ddenchevDev/Electronics-Projects-Public/System_requirements.docx

Stage 1 – Broad description

“Mixed-Signal , Mono, DSP Guitar effects pedal”

How is it going to be used?: Simple effects will be implemented – filters, distortion/overdrive, compression, time-based effects, modulation effects

Stage 2 – Deep Dive

Power? – 9V power input ( female barrel connector – 5.5/2.1mm) from standard guitar pedal PSU

Mono? – Mono single channel converters (ADC + DAC/CODEC)

Guitar Effects Pedal:

- Enclosure - Must fit in a standard Hammond 1590B enclosure
- Sample Rate – 44.1 – 48kHz sattisfies the Nyquist limit for a guitar pedal, where the maximum input frequency to be sampled is 20kHz
- Bit Depth – 24 bits
- Power - 9V power input ( female barrel connector – 5.5/2.1mm) from standard guitar pedal PSU
- USB Data Streaming
- Analog IO – 6.3mm female phone jacks
- Controls – 3 potentiometers -> 3 internal ADC channels for low frequency polling. 2 switches -> 2 digital inputs
- User interface – 1 led for tap tempo/modulation speed indication -> digital output with PWM channel

Stage 3 – Simplified Block Diagram

Power Supply

Processor

Data Converters

Input Connector

Output Connector

USB Connector

User Interface

Stage 4 – Adding details

4.1.USB

- USB 2.0 Full-Speed – only single channel audio streaming will be used. For an audio bit depth of 24 bits (transferred using a 32-bit frame) and a sampling frequency of 48kHz (worst case), the resulting data bandwidth will be:

24 bits * 48k samples/s = 1.536Mb/s

The USB 2.0 Full-Speed standard specifies a bandwidth of 12Mb/s -> can comfortably be used for single channel data transmission

- USB type C connector – widely used and supported in today’s designs

4.2.Processor

Initial Considerations:

- Peripherals – USB 2.0 Full Speed, 2 x I2S channels, 3 internal ADC channels for control potentiometers, I2C and SPI (for configuration of converters), Serial-wire debug
- RAM – enough to support RAM intensive DSP effects. Time based Delay/Reverb effects consume large ammounts of RAM e.g. for a 1s audio delay:

48k samples/s * 32 bit frame = 192 000 B = 187.5 KB

USB stack + middleware = 20-40 KB

230KB as a rough bare minimum!

- Design-friendly package – LQFP – simpler PCB design and lower production costs 🙂
- Availability and support – should have a large stock in the major parts distributors and should be active
- Processing power – Arm Cortex M4 Processors are more than sufficient for simple DSP tasks

Final Choice – STM32F469

4.3.Power Supplies

Initial Considerations:

- Digital and Analog supplies will be split

- Digital supply – switching regulator(s) will be used since the digital circuitry is far more tolerant to noise.

- Analog supply – a simple LDO regulator can be used as analog circuitry typically draws currents in the 10s of mA maximum, so regulator efficiency shouldn’t be of concern. Analog supplies also require a clean, low-noise supply, so switching converters are not an option

- Power Input – Standard 9V guitar pedal PSU. Usually these PSUs are stabilized ,and even slight variations in the output voltage shouldn’t cause issues with regulator drop-out voltages as there is plenty of margin.

4.4.Converters

Initial Considerations:

- Bit depth – 24 bits will provide good SNR ratio and is also a widely used standard for audio processing application
- Sampling rate – higher sampling rates (with a higher Nyquist limit!) result in less aliasing, however the negative side effect is increased data bandwidth to be processed and transferred. 44.1-48kHz is the optimum middle ground for guitar pedal architectures
- Interfaces:
- I2S for data streaming. Many MCUs have an I2S module implemented (including the chosen F469 MCU).
- SPI or I2C for configuration – either will work sufficiently
- Design-Friendly Package – TSSOP, SOIC and LQFP packages are less costly to assemble and easier to debug

Final selection: Cirrus Logic CS4270-CZZR

Advantages:

- Low cost – 2.05$ per piece

- Easy to assemble/debug package – TSSOP-24

- Pin layout is adequate for good separation of digital and analog sides

- Can reach sample rates of up to 192kHz

- Stereo – possibilities for design up-scaling

4.5.Analogue Sections

For ADC (analogue front end):

- High Impedance – 1Mohm will add versatillity – everything from single-coils to active humbuckers can be supported without noticeable tonal loss
- ESD protection and RF filtering are mandatory!
- Anti-aliasing filter with cut-off frequency at Nyquist limit

For DAC (analogue rear end):

- Low Impedance – 100ohms will ensure that negligible high-frequency rolloff will be encountered when connecting to long cables.
- ESD protection is a must!
- Anti-aliasing filter with cut-off frequency at Nyquist limit
- Single-ended output

4.6.Miscellaneous

4.6.1.Mechanical:

-PCB dimensions - must fit into a standard Hammond 1590B enclosure (internal dimensions are 55x107x27mm) with room for external components

-Connectors:

- 6.35mm Phone jacks for audio IO – PCB mounted
- USB C for programming/data streaming
- Male pin header for programming SWD
- Female power connector – 5.5x2.1mm

-Peripherals:

- Two LEDs for debugging and effects indicators (delay tempo, mod speed etc.) – implemented as GPIO header
- Three analogue inputs for parameter adjustment (e.g. potentiometers) – implemented as GPIO header
- Two switches for parameter adjustment – added on GPIO header

Stage 5 – Detailed Block Diagram

GPIO Header

SWD Connector

Power Supplies

9V DC

Power Connector

5.5x2.1mm

Digital Supply 3.3V

Analog Supply 3.3V

Opamp Bias Generator

MCU

USB 2.0 FS

USB C Connector

Xtal OSC

I2S

USB PHY

SWD

I2S

Timers

Digital Inputs

ADC 24 Bit

DAC 24 Bit

Analogue Front-End

Analogue Rear-End

Converters

Stage 6 - Power Supplies – Deep Dive:

6.1.Digital supply:

- Switching, step-down/buck converter
- Input voltage is +9V, output voltage is +3.3V
- Current requirements: IMCU + ICODEC + ILEDs
- MCU current draw for digital supply (@ fclock=180MHz, Tambient=25OC) = 109mA
- CODEC current draw (using worst-case values from datasheet): ICODEC Analog + ICODEC Digital = 42mA + 38mA = 80mA
- LEDs current draw – 2x20mA worst case = 40mA
- Total current draw: 229mA
- Adding headroom of 100% -> the chosen switching converter should be able to deliver about 460mA continuously

Final choice: TPS562246

- Efficiency – Up to 90%
- Max current -2A
- 4.2V < Vin <17V
- 0.6V < Vout < 7V
- Switching frequency 1.28MHz
- SOT Package

6.2.Analog supply

6.2.1.MCU Analog Supply

- LDO (low-dropout) regulator
- Input-output voltage differential will be 9V-3.3V = 5.7V
- Low current requirement. Don’t need high efficiency
- Low noise requirement

Final choice: HT7533-1

- Maximum input voltage up to +30V
- Maximum output current 100mA
- SOT89-3 package

6.2.2.CODEC Analog Supply

- Output is +5V
- Maximum current draw of CODEC analog supply is 42mA
- All other requirements are same as pt.6.2.1

Final choice: HT7550-1

Stage 7 – Analogue Circuitry – part selection

7.1.Op-Amps

- MOS input stage -> higher impedance and lower bias currents
- Rail-to-rail
- Single-supply
- Enough GBWP for higher order filters in analogue front and rear ends
- Easy to assemble package

Final choice: MCP6001

7.2.Passive components

- Aim for lower resistance values (where possible!) ,to reduce Johnson noise contribution
- Aim to use a smaller variety of component values, to simplify BOM and reduce overall cost (BOM consolidation)
