ddenchevDev/Electronics-Projects-Public/STM32_Audio_DSP_board/DeniSP/DeniSP_schematic.pdf

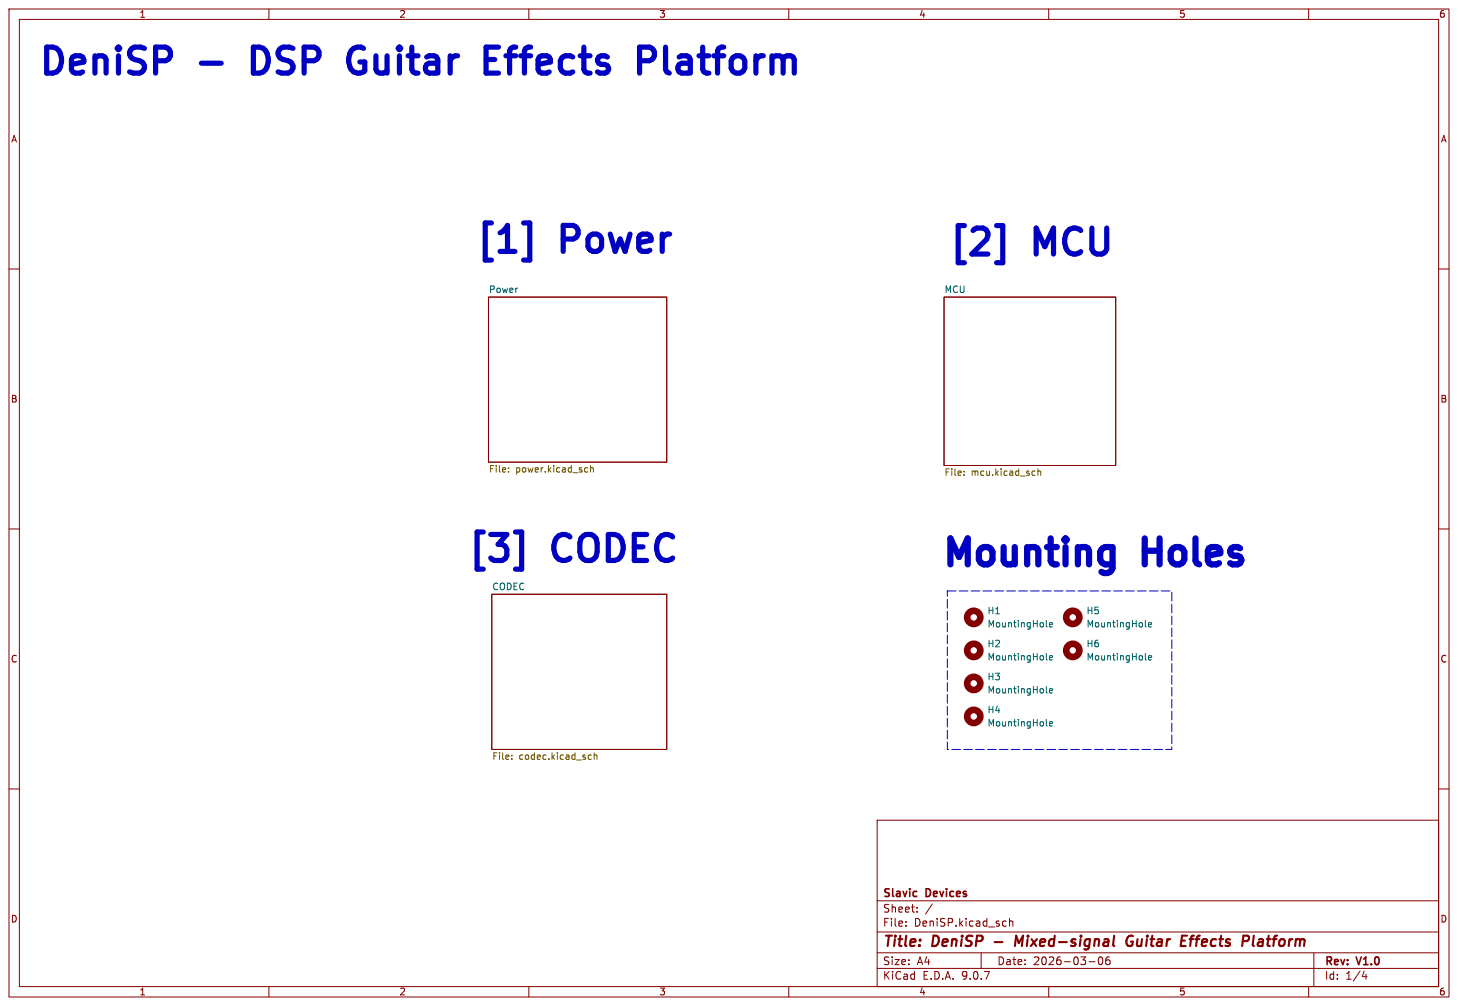
[picture p1: page 1]

File: mcu.kicad_sch Power File: power.kicad_sch CODEC

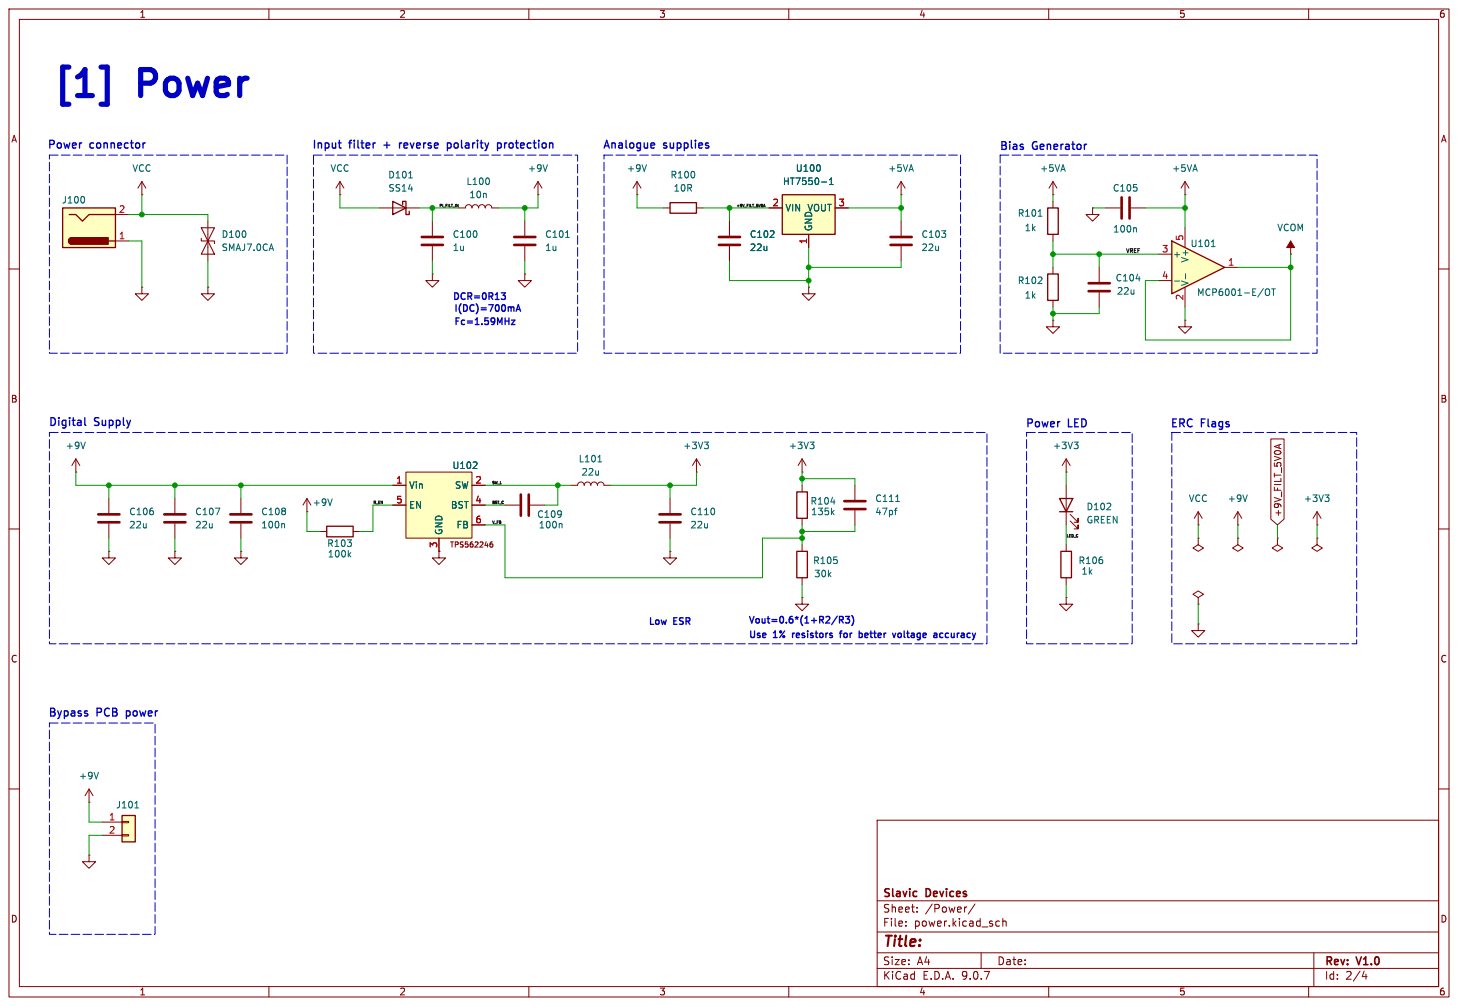
[picture p2: page 2]

Low ESR Analogue supplies

1 VOUT 3 U102 Vin 1 EN 5 GND

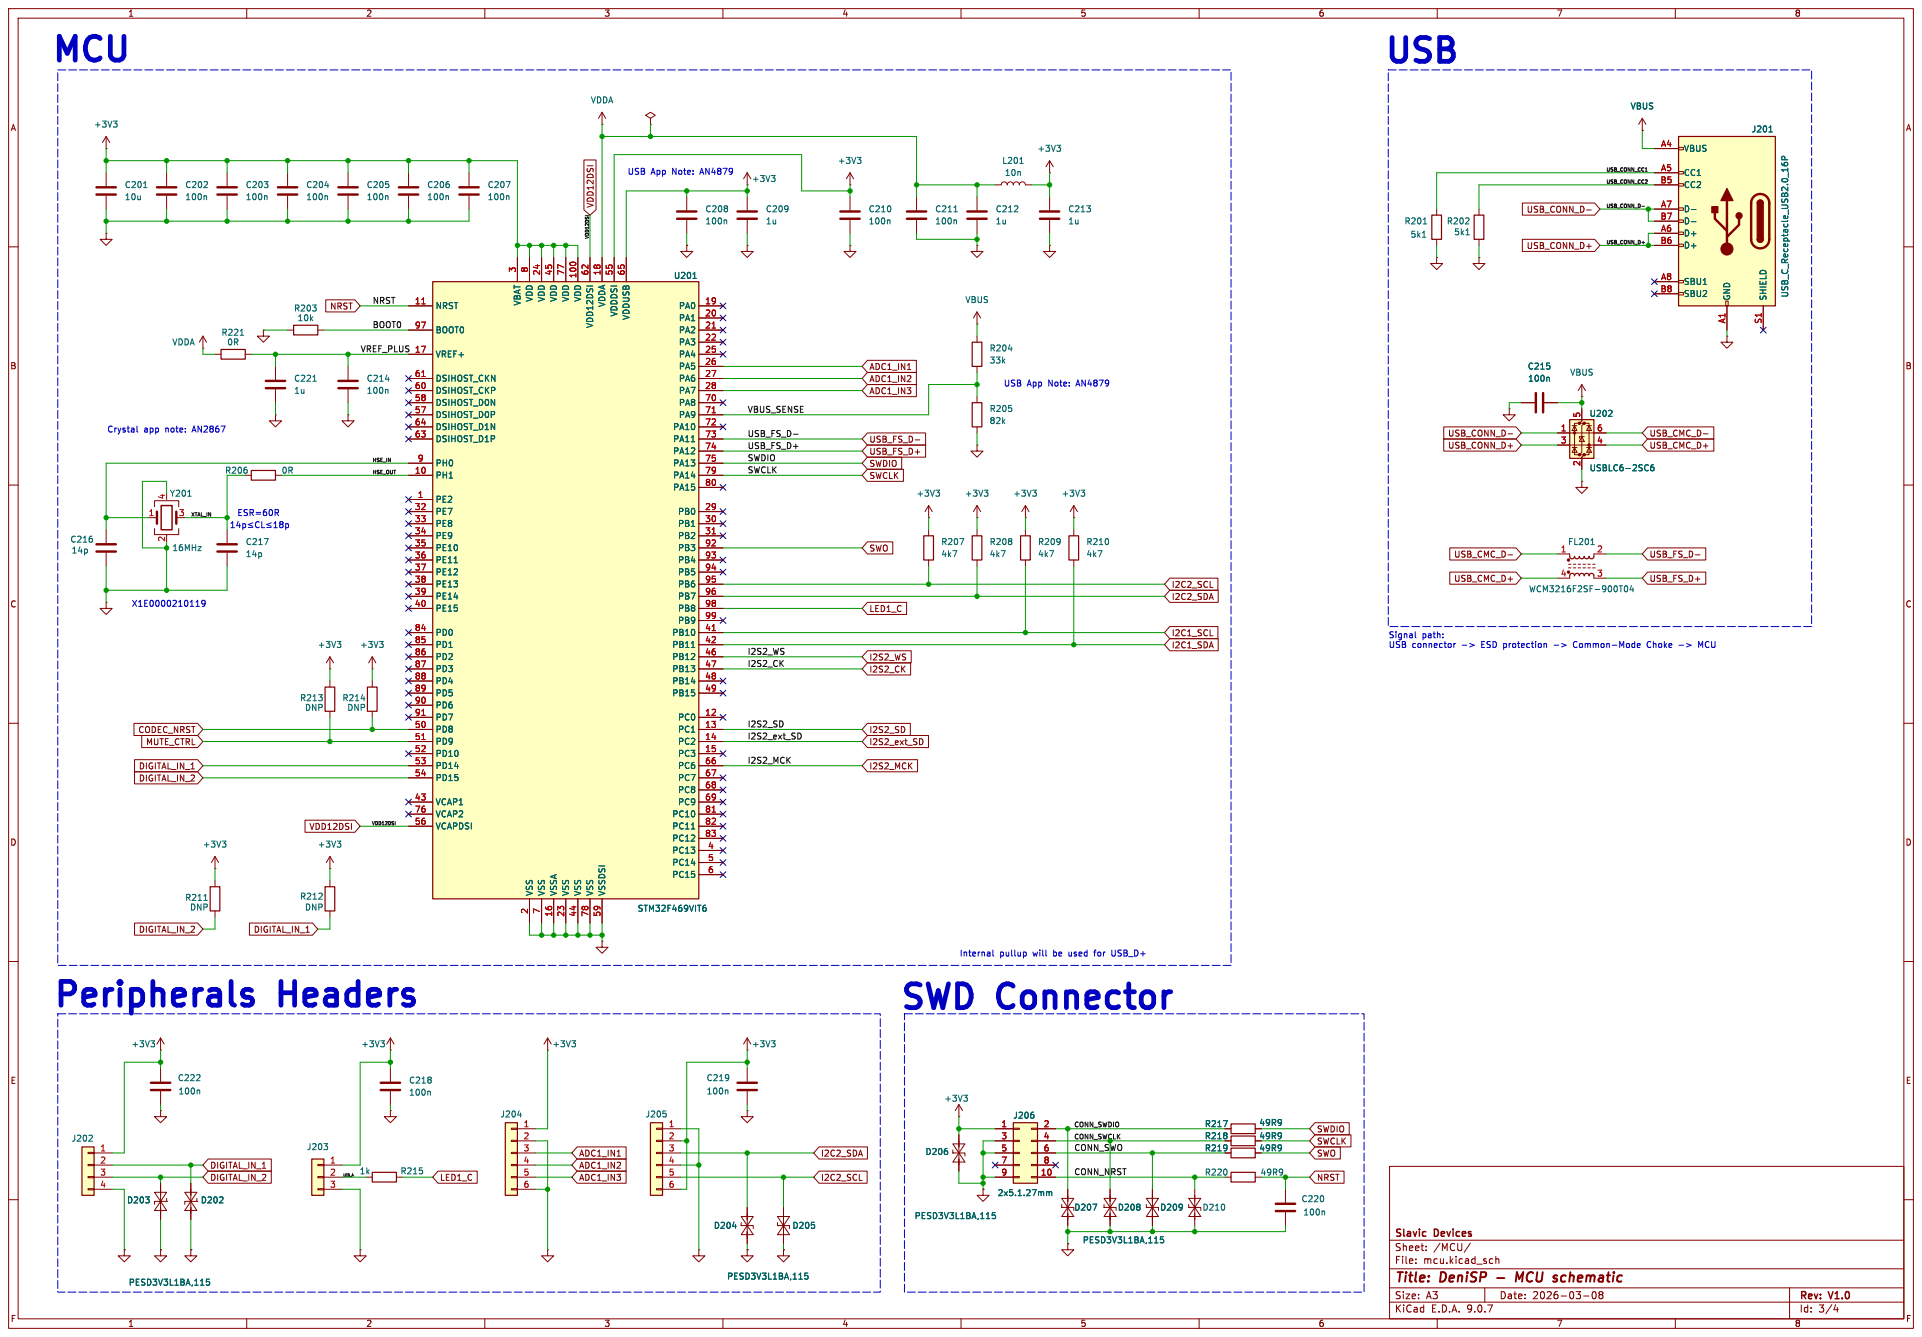
[picture p3: page 3]

Crystal app note: AN2867 X1E0000210119 MCU
I2S2_ext_SD VDD12DSI

7 VDD 45 VSSA 16 VDD 77 VSS 23 VDD 100 VSS 44 VDD12DSI 62 VSS 78 VDDA 18 VSSDSI 59 VDDDSI 55 VDDUSB 65 PA0 19 PA1 20 PA2 21 PA3 22 PA4 25 PA5 26 PA6 27 PA7 28 PA8 70 PA9 71 PA10 72 PA11 73 PA12 74 PA13 75 PA14 79 PA15 80 PB0 29 PB1 30 PB2 31 PB3 92 PB4 93 PB5 94 PB6 95 PB7 96 PB8 98 PB9 99 PB10 41 PB11 42 PB12 46 PB13 47 PB14 48 PB15 49 PC0 12 PC1 13 PC2 14 PC3 15 PC6 66 PC7 67 PC8 68 PC9 69 PC10 81 PC11 82 PC12 83 PC13 4 PC14 5 PC15 6

Id: 3/4 Title: DeniSP - MCU schematic

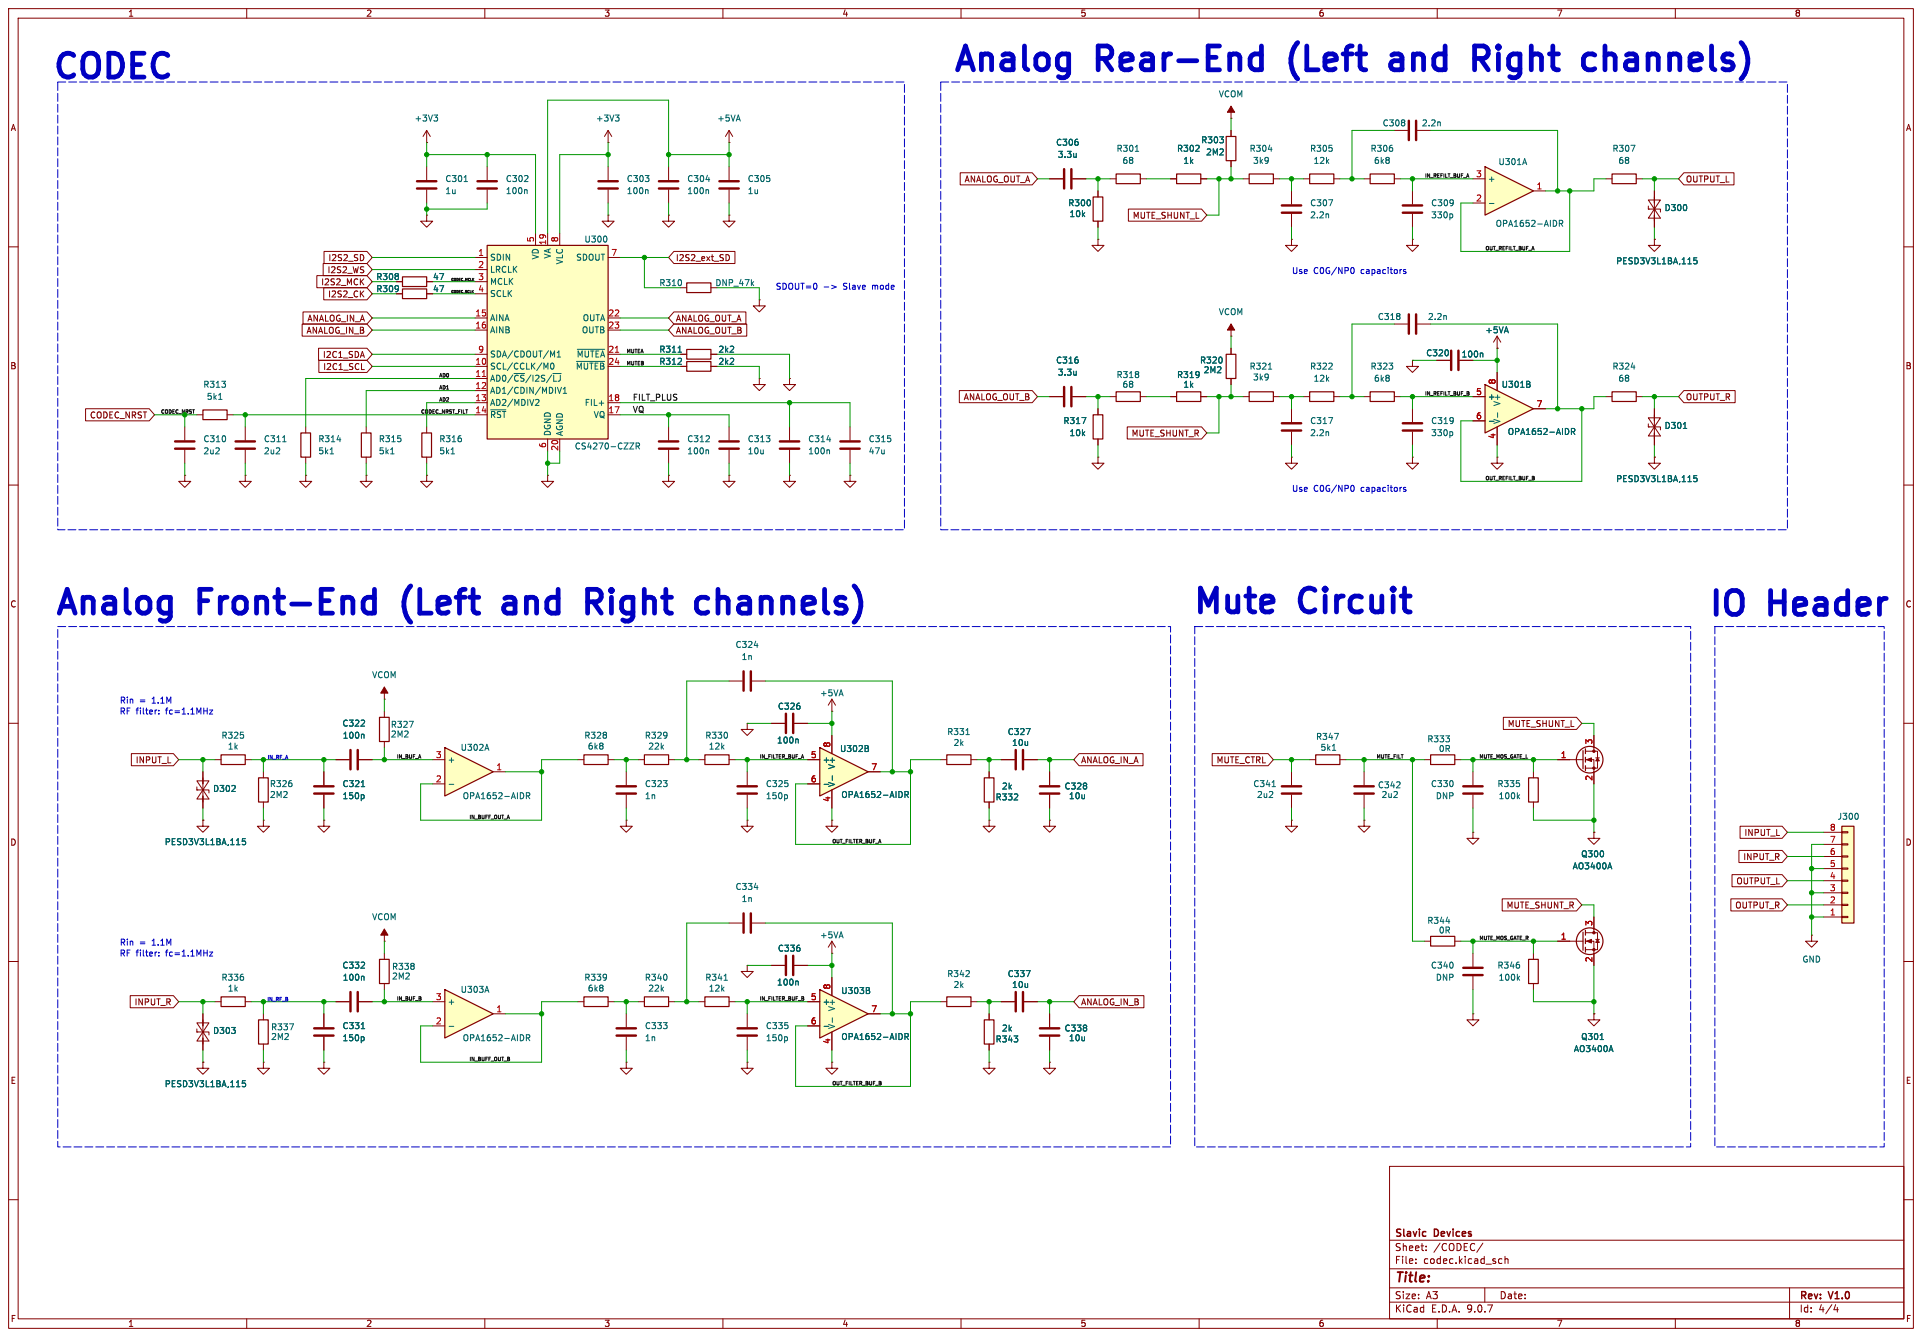
[picture p4: page 4]

8 AGND 20 SDOUT 7 OUTA 22 OUTB 23 ~{MUTEA} 21 ~{MUTEB} 24 FIL+ 18 VQ 17 U300 CS4270-CZZR
MUTEA MUTEB VQ
