ddenchevDev/Electronics-Projects-Public/STM32_Audio_DSP_board/DeniSP/DeniSP.kicad_pcb

## KiCad design STM32_Audio_DSP_board/DeniSP/DeniSP.kicad_pcb (2026-09-20)

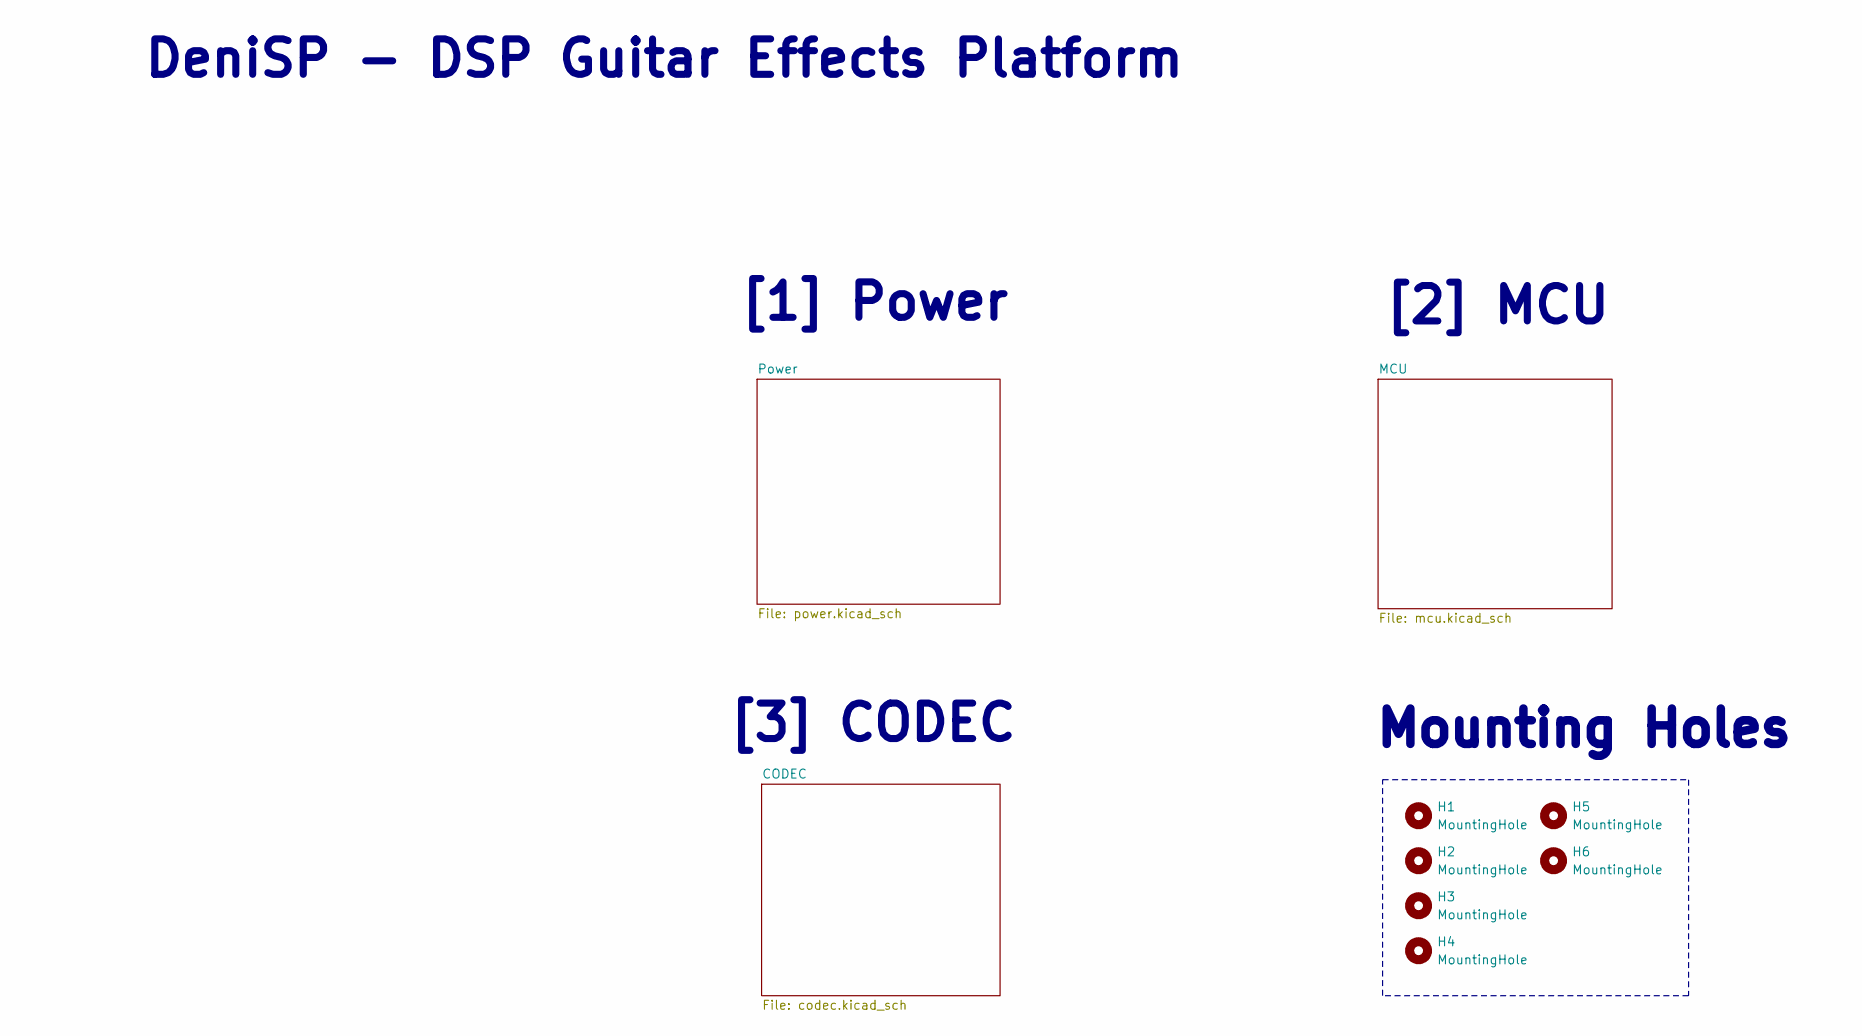
[picture p5: schematic DeniSP.kicad_sch, DeniSP - Mixed-signal Guitar Effects Platform]

Parts:
H1, H2, H3, H4, H5, H6: MountingHole; MountingHole_3.2mm_M3

Notes on the sheet:
[2] MCU
DeniSP - DSP Guitar Effects Platform
[1] Power
Mounting Holes
[3] CODEC

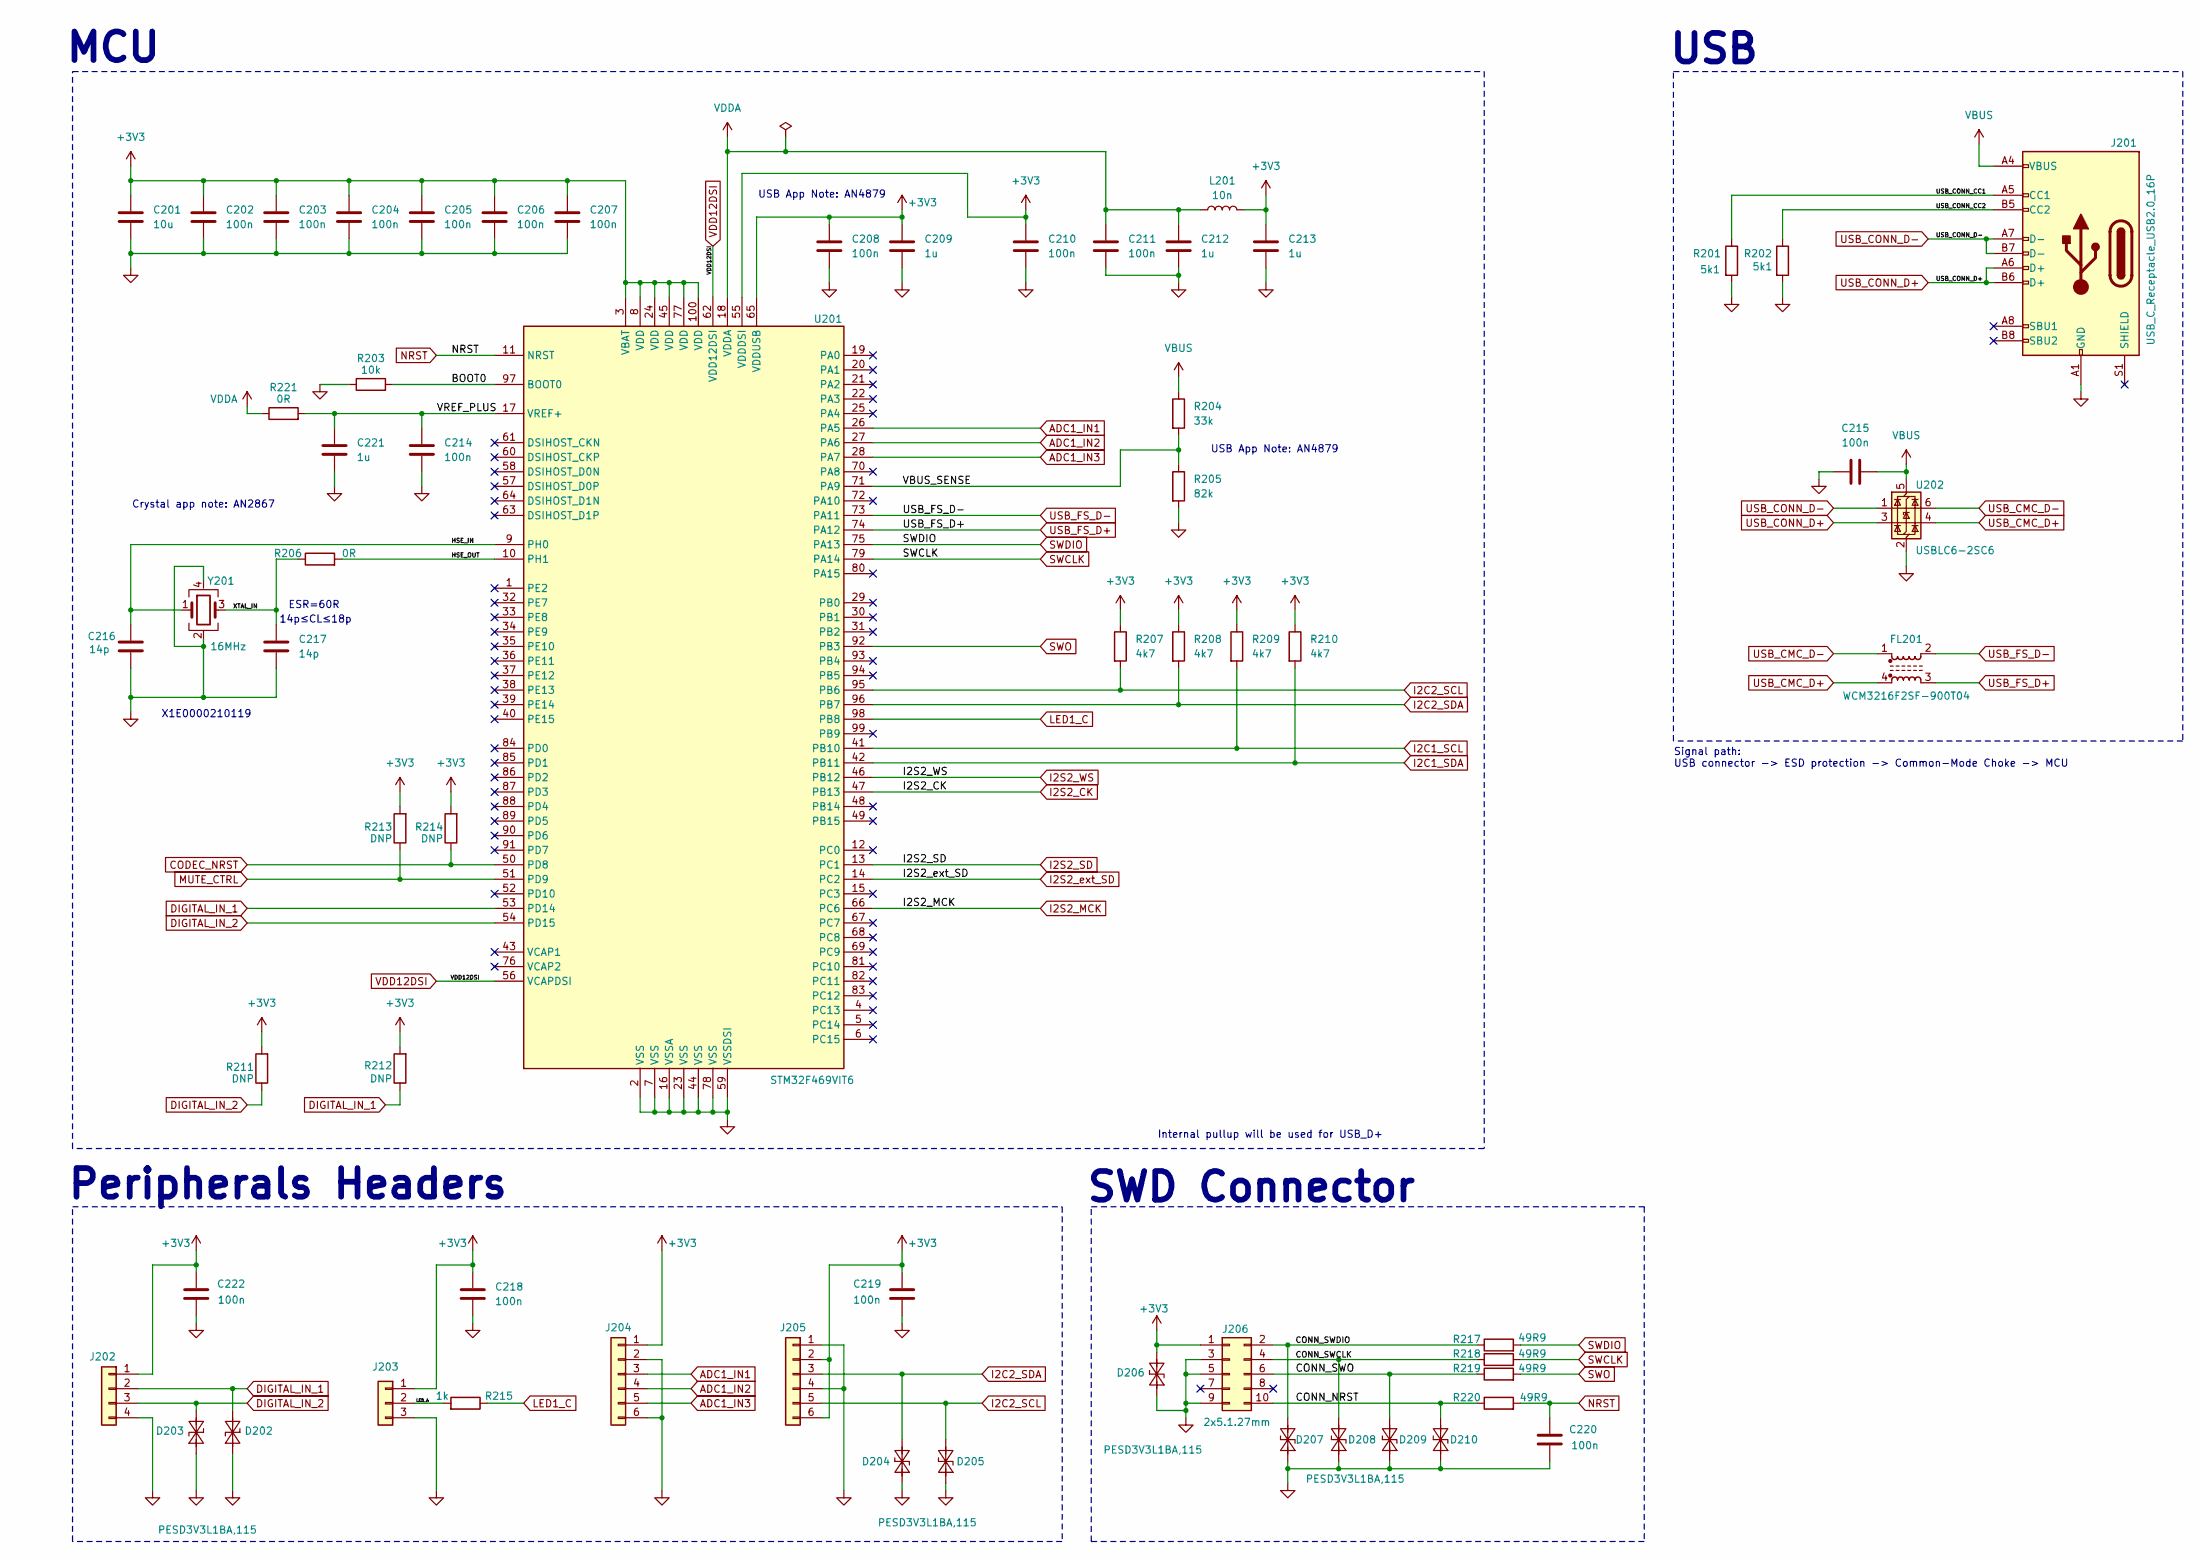
[picture p6: schematic mcu.kicad_sch, DeniSP - MCU schematic]

Parts:
C201: 10u; C_0603_1608Metric; JLCPCB Part # C1691
C202, C203, C204, C205, C206, C207, C208, C210, C211, C214, C215, C218, C219, C220, C222: 100n; C_0402_1005Metric; JLCPCB Part # C1525
C209, C212, C213, C221: 1u; C_0603_1608Metric; JLCPCB Part # C6119852
C216, C217: 14p; C_0402_1005Metric; JLCPCB Part # C3037644
D202, D203, D204, D205, D206, D207, D208, D209, D210: PESD3V3L1BA,115; D_SOD-323; JLCPCB Part # C41364896
FL201: WCM3216F2SF-900T04; CMC_3216-4P; JLCPCB Part # C357319
J201: USB_C_Receptacle_USB2.0_16P; USB_C_Receptacle_G-Switch_GT-USB-7010ASV; JLCPCB Part # C2988369
J202: Conn_01x04; PinHeader_1x04_P2.54mm_Vertical
J203: Conn_01x03; PinHeader_1x03_P2.54mm_Vertical
J204: Conn_01x06; PinHeader_1x06_P2.54mm_Vertical
J205: FH34SRJ-6S-0.5SH(50); FPC_6; JLCPCB Part # C224194
J206: 2x5.1.27mm; PinHeader_2x05_P1.27mm_Vertical_SMD; JLCPCB Part # C41370773
L201: 10n; L_0402_1005Metric; JLCPCB Part # C77103
R201, R202: 5k1; R_0402_1005Metric; JLCPCB Part # C2906948
R203: 10k; R_0402_1005Metric; JLCPCB Part # C60489
R204: 33k; R_0402_1005Metric; JLCPCB Part # C138003
R205: 82k; R_0402_1005Metric; JLCPCB Part # C2909388
R206, R221: 0R; R_0402_1005Metric; JLCPCB Part # C2906877
R207, R208, R209, R210: 4k7; R_0402_1005Metric; JLCPCB Part # C2906941
R211, R212, R213, R214: DNP; R_0402_1005Metric
R215: 1k; R_0603_1608Metric; JLCPCB Part # C2907113
R217, R218, R219, R220: 49R9; R_0402_1005Metric; JLCPCB Part # C25120
U201: STM32F469VIT6; LQFP-100_14x14mm_P0.5mm; JLCPCB Part # C2970187
U202: USBLC6-2SC6; SOT-23-6; JLCPCB Part # C2687116
Y201: 16MHz; Crystal_SMD_3225-4Pin_3.2x2.5mm; JLCPCB Part # C89371

Connections:
+3V3: C201.1, C202.1, C203.1, C204.1, C205.1, C206.1, C207.1, C208.1, C209.1, C210.1, C213.1, C218.1, C219.1, C222.1, D206.1, J202.1, J203.1, J204.1, J205.2, J205.6, J206.1, L201.2, R207.1, R208.1, R209.1, R210.1, R211.2, R212.2, R213.2, R214.2, U201.3 (VBAT), U201.8 (VDD), U201.24 (VDD), U201.45 (VDD), U201.55 (VDDDSI), U201.65 (VDDUSB), U201.77 (VDD), U201.100 (VDD); also elsewhere on the board
/MCU/BOOT0: R203.2, U201.97 (BOOT0)
/MCU/CONN_NRST: D210.1, J206.10, R220.1
/MCU/CONN_SWCLK: D208.1, J206.4, R218.1
/MCU/CONN_SWDIO: D207.1, J206.2, R217.1
/MCU/CONN_SWO: D209.1, J206.6, R219.1
/MCU/HSE_IN: C216.1, U201.9 (PH0), Y201.1
/MCU/HSE_OUT: R206.2, U201.10 (PH1)
/MCU/LED_A: J203.2, R215.2
/MCU/USB_CONN_CC1: J201.A5 (CC1), R201.1
/MCU/USB_CONN_CC2: J201.B5 (CC2), R202.1
/MCU/VBUS_SENSE: R204.2, R205.1, U201.71 (PA9)
/MCU/VREF_PLUS: C214.1, C221.1, R221.2, U201.17 (VREF+)
/MCU/XTAL_IN: C217.1, R206.1, Y201.3
ADC1_IN1: J204.3, U201.26 (PA5)
ADC1_IN2: J204.4, U201.27 (PA6)
ADC1_IN3: J204.5, U201.28 (PA7)
CODEC_NRST: R214.1, U201.50 (PD8); also elsewhere on the board
DIGITAL_IN_1: D202.1, J202.2, R212.1, U201.53 (PD14)
DIGITAL_IN_2: D203.1, J202.3, R211.1, U201.54 (PD15)
GND: C201.2, C202.2, C203.2, C204.2, C205.2, C206.2, C207.2, C208.2, C209.2, C210.2, C211.2, C212.2, C213.2, C214.2, C215.1, C216.2, C217.2, C218.2, C219.2, C220.2, C221.2, C222.2, D202.2, D203.2, D204.2, D205.2, D206.2, D207.2, D208.2, D209.2, D210.2, J201.A1 (GND), J201.A12 (GND), J201.B1 (GND), J201.B12 (GND), J202.4, J203.3, J204.2, J204.6, J205.1, J205.4, J206.3, J206.5, J206.9, R201.2, R202.2, R203.1, R205.2, U201.2 (VSS), U201.7 (VSS), U201.16 (VSSA), U201.23 (VSS), U201.44 (VSS), U201.59 (VSSDSI), U201.78 (VSS), U202.2 (GND), Y201.2 (G), Y201.4 (G); also elsewhere on the board
I2C1_SCL: R209.2, U201.41 (PB10); also elsewhere on the board
I2C1_SDA: R210.2, U201.42 (PB11); also elsewhere on the board
I2C2_SCL: D205.1, J205.5, R207.2, U201.95 (PB6)
I2C2_SDA: D204.1, J205.3, R208.2, U201.96 (PB7)
I2S2_CK: U201.47 (PB13); also elsewhere on the board
I2S2_MCK: U201.66 (PC6); also elsewhere on the board
I2S2_SD: U201.13 (PC1); also elsewhere on the board
I2S2_WS: U201.46 (PB12); also elsewhere on the board
I2S2_ext_SD: U201.14 (PC2); also elsewhere on the board
LED1_C: R215.1, U201.98 (PB8)
MUTE_CTRL: R213.1, U201.51 (PD9); also elsewhere on the board
NRST: C220.1, R220.2, U201.11 (NRST)
SWCLK: R218.2, U201.79 (PA14)
SWDIO: R217.2, U201.75 (PA13)
SWO: R219.2, U201.92 (PB3)
USB_CMC_D+: FL201.4, U202.4 (I/O2)
USB_CMC_D-: FL201.1, U202.6 (I/O1)
USB_CONN_D+: J201.A6 (D+), J201.B6 (D+), U202.3 (I/O2)
USB_CONN_D-: J201.A7 (D-), J201.B7 (D-), U202.1 (I/O1)
USB_FS_D+: FL201.3, U201.74 (PA12)
USB_FS_D-: FL201.2, U201.73 (PA11)
VBUS: C215.2, J201.A4 (VBUS), J201.A9 (VBUS), J201.B4 (VBUS), J201.B9 (VBUS), R204.1, U202.5 (VBUS)
VDD12DSI: U201.56 (VCAPDSI), U201.62 (VDD12DSI)
VDDA: C211.1, C212.1, L201.1, R221.1, U201.18 (VDDA)

Notes on the sheet:
X1E0000210119
Crystal app note: AN2867
USB
Peripherals Headers
ESR=60R
14p≤CL≤18p
USB App Note: AN4879
Signal path: USB connector -> ESD protection -> Common-Mode Choke -> MCU
SWD Connector
MCU
Internal pullup will be used for USB_D+

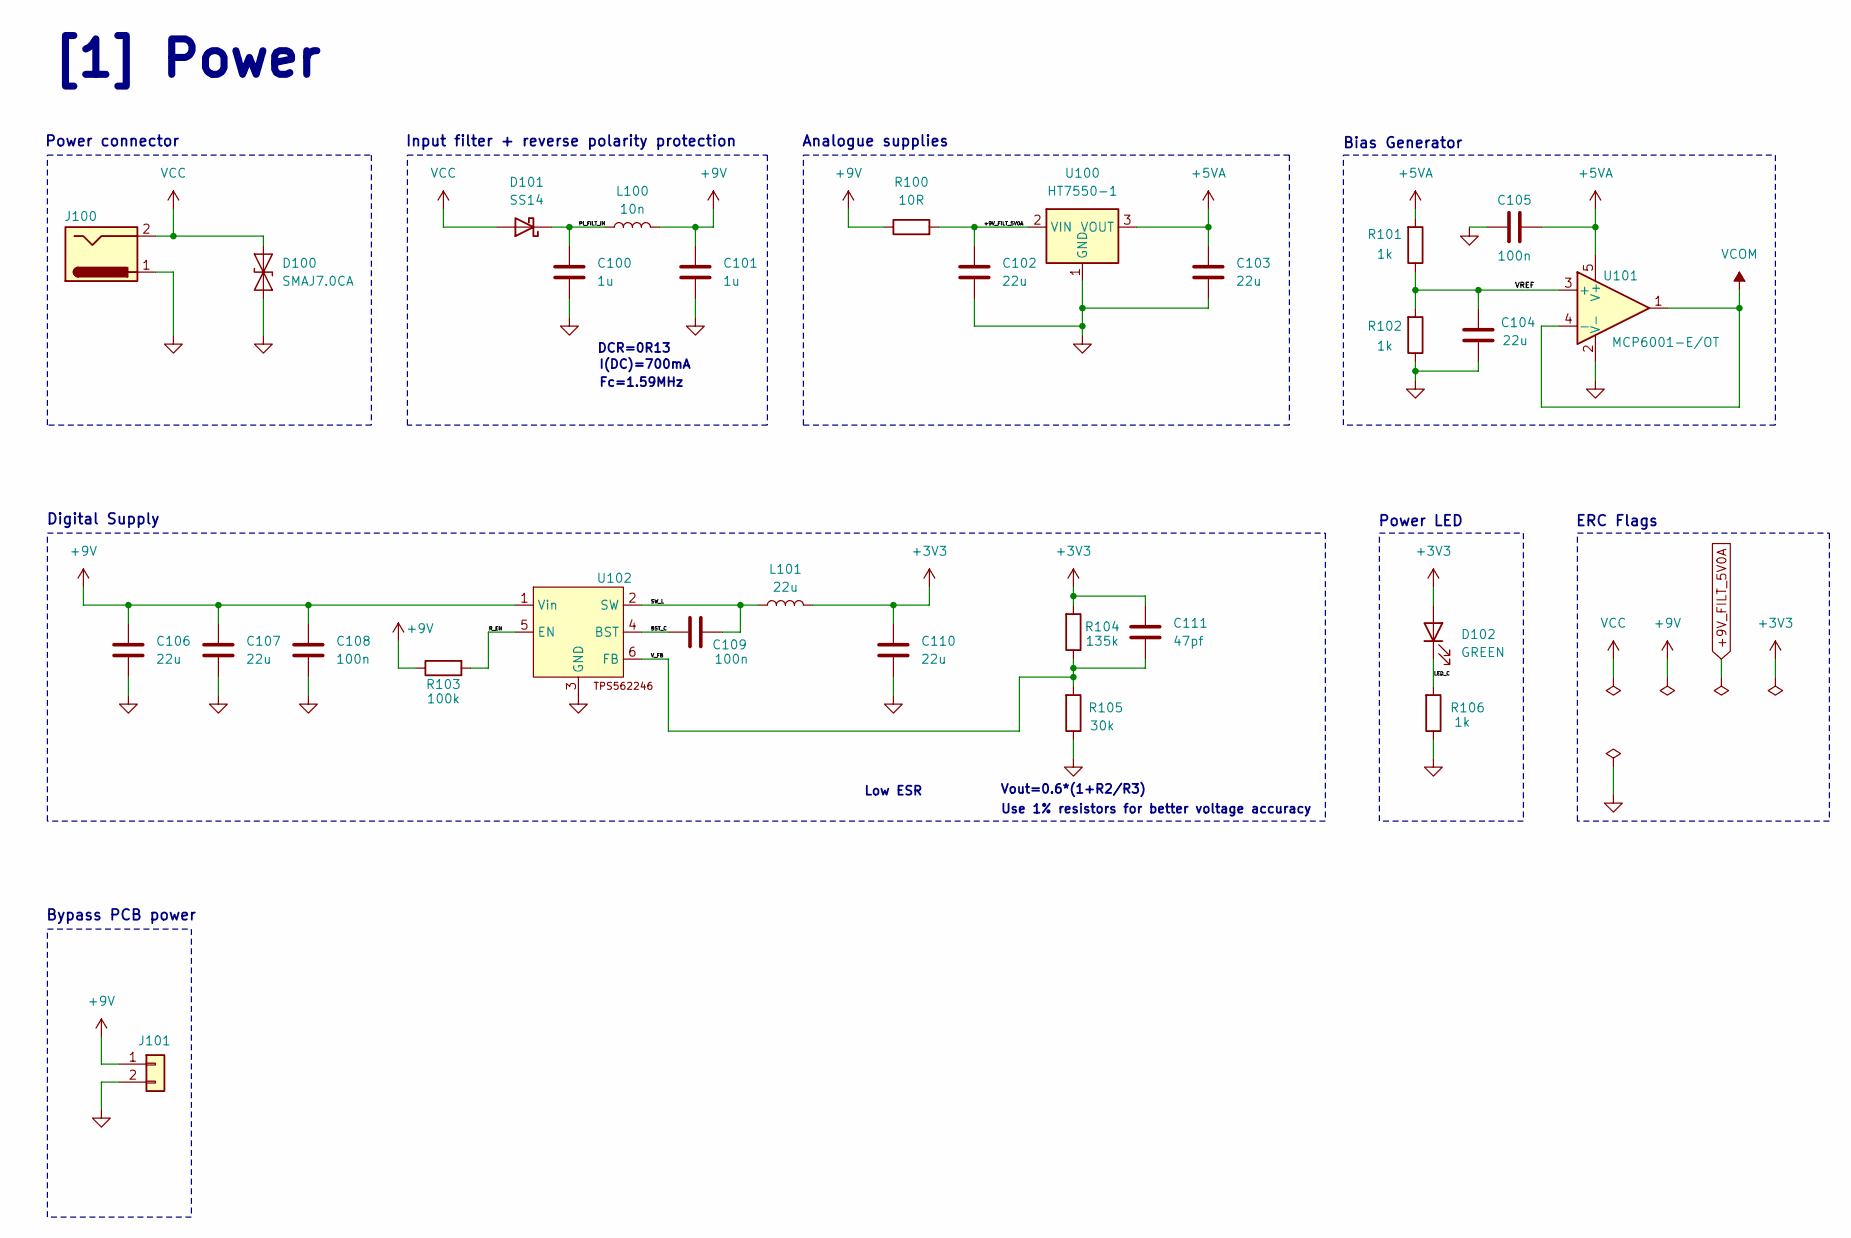
[picture p7: schematic power.kicad_sch]

Parts:
C100, C101: 1u; C_0603_1608Metric; JLCPCB Part # C6119852
C102, C103, C104, C106, C107: 22u; C_0805_2012Metric; JLCPCB Part # C6119899
C105, C108, C109: 100n; C_0402_1005Metric; JLCPCB Part # C1525
C110: 22u; C_0805_2012Metric; Voltage 25V; JLCPCB Part # C6119899
C111: 47pf; C_0402_1005Metric; JLCPCB Part # C60137
D100: SMAJ7.0CA; D_SMA; JLCPCB Part # C353427
D101: SS14; D_SMA; JLCPCB Part # C2837270
D102: GREEN; LED_0603_1608Metric; JLCPCB Part # C22371297
J100: Barrel_Jack; BarrelJack_Kycon_KLDX-0202-xC_Horizontal
J101: Conn_01x02; PinSocket_1x02_P2.54mm_Vertical
L100: 10n; L_0603_1608Metric; JLCPCB Part # C6807993
L101: 22u; L_Changjiang_FXL0630; JLCPCB Part # C177244
R100: 10R; R_0805_2012Metric; JLCPCB Part # C727983
R101, R102: 1k; R_0603_1608Metric; JLCPCB Part # C2907113
R103: 100k; R_0402_1005Metric; JLCPCB Part # C2906859
R104: 135k; R_0402_1005Metric; JLCPCB Part # C2515705
R105: 30k; R_0402_1005Metric; JLCPCB Part # C2909347
R106: 1k; R_0805_2012Metric; JLCPCB Part # C2907295
U100: HT7550-1; SOT-89-3; JLCPCB Part # C16106
U101: MCP6001-E/OT; SOT-23-5; JLCPCB Part # C29429
U102: TPS562246; SOT-563; JLCPCB Part # C41833479

Connections:
+3V3: C110.1, C111.1, D102.2 (A), L101.2, R104.2; also elsewhere on the board
+5VA: C103.1, C105.2, R101.2, U100.3 (VOUT), U101.5 (V+); also elsewhere on the board
+9V: C101.1, C106.1, C107.1, C108.1, J101.1, L100.2, R100.1, R103.1, U102.1 (Vin)
+9V_FILT_5V0A: C102.1, R100.2, U100.2 (VIN)
/Power/BST_C: C109.1, U102.4 (BST)
/Power/LED_C: D102.1 (K), R106.2
/Power/PI_FILT_IN: C100.1, D101.1 (K), L100.1
/Power/R_EN: R103.2, U102.5 (EN)
/Power/SW_L: C109.2, L101.1, U102.2 (SW)
/Power/VREF: C104.1, R101.1, R102.2, U101.3 (+)
/Power/V_FB: C111.2, R104.1, R105.2, U102.6 (FB)
GND: C100.2, C101.2, C102.2, C103.2, C104.2, C105.1, C106.2, C107.2, C108.2, C110.2, D100.1 (A1), J100.1, J101.2, R102.1, R105.1, R106.1, U100.1 (GND), U101.2 (V-), U102.3 (GND); also elsewhere on the board
VCC: D100.2 (A2), D101.2 (A), J100.2
VCOM: U101.1, U101.4 (-); also elsewhere on the board

Notes on the sheet:
Bypass PCB power
ERC Flags
Bias Generator
Digital Supply
I(DC)=700mA
Vout=0.6*(1+R2/R3)
Use 1% resistors for better voltage accuracy
[1] Power
Input filter + reverse polarity protection
DCR=0R13
Power connector
Power LED
Fc=1.59MHz
Low ESR
Analogue supplies

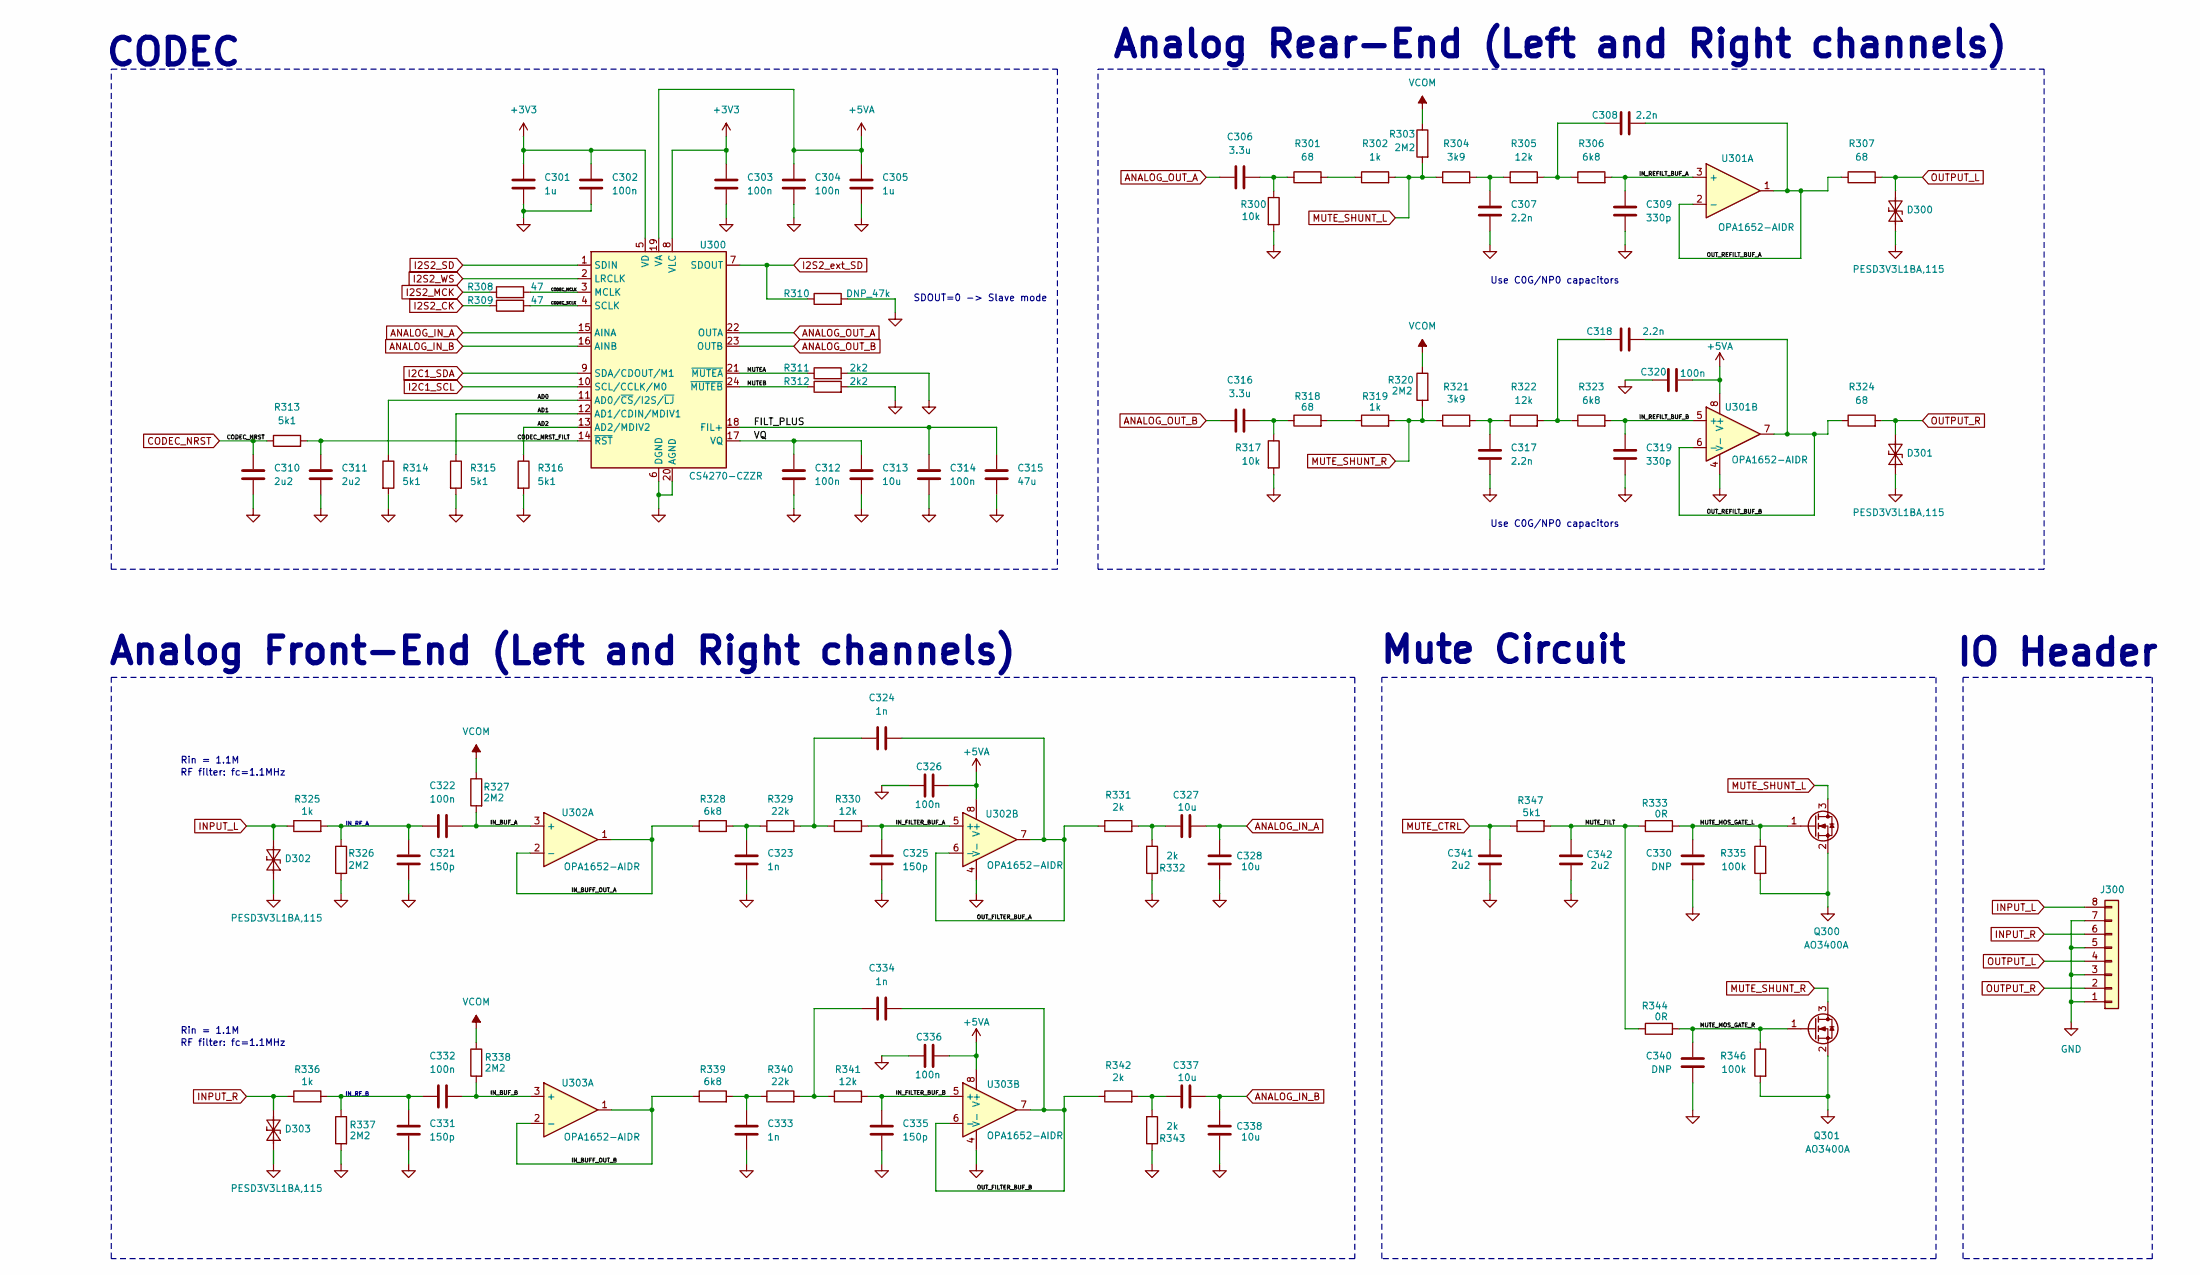
[picture p8: schematic codec.kicad_sch]

Parts:
C301, C305: 1u; C_0603_1608Metric; JLCPCB Part # C6119852
C302, C303, C304, C312, C314, C320, C326, C336: 100n; C_0402_1005Metric; JLCPCB Part # C1525
C306, C316: 3.3u; C_0603_1608Metric; JLCPCB Part # C51412
C307, C308, C317, C318: 2.2n; C_0603_1608Metric; JLCPCB Part # C107082
C309, C319: 330p; C_0603_1608Metric; JLCPCB Part # C1664
C310, C311, C341, C342: 2u2; C_0603_1608Metric; JLCPCB Part # C23630
C313, C327, C328, C337, C338: 10u; C_0603_1608Metric; JLCPCB Part # C1691
C315: 47u; C_0603_1608Metric; JLCPCB Part # C140782
C321, C325, C331, C335: 150p; C_0603_1608Metric; JLCPCB Part # C107038
C322, C332: 100n; C_0603_1608Metric; JLCPCB Part # C14663
C323, C324, C333, C334: 1n; C_0603_1608Metric; JLCPCB Part # C100040
C330, C340: DNP; C_0603_1608Metric
D300, D301, D302, D303: PESD3V3L1BA,115; D_SOD-323; JLCPCB Part # C41364896
J300: Conn_01x08; PinHeader_1x08_P2.54mm_Vertical
Q300, Q301: AO3400A; SOT-23; JLCPCB Part # C20917
R300, R317: 10k; R_0603_1608Metric; JLCPCB Part # C2906982
R301, R307, R318, R324: 68; R_0603_1608Metric; JLCPCB Part # C27592
R302, R319, R325, R336: 1k; R_0603_1608Metric; JLCPCB Part # C2907113
R303, R320, R326, R327, R337, R338: 2M2; R_0603_1608Metric; JLCPCB Part # C2930031
R304, R321: 3k9; R_0603_1608Metric; JLCPCB Part # C2907024
R305, R322, R330, R341: 12k; R_0603_1608Metric; JLCPCB Part # C114659
R306, R323, R328, R339: 6k8; R_0603_1608Metric; JLCPCB Part # C114632
R308, R309: 47; R_0402_1005Metric; JLCPCB Part # C2909362
R310: DNP_47k; R_0402_1005Metric
R311, R312: 2k2; R_0402_1005Metric; JLCPCB Part # C2906920
R313, R314, R315, R316, R347: 5k1; R_0402_1005Metric; JLCPCB Part # C2906948
R329, R340: 22k; R_0603_1608Metric; JLCPCB Part # C31850
R331, R332, R342, R343: 2k; R_0603_1608Metric; JLCPCB Part # C2907137
R333, R344: 0R; R_0603_1608Metric; JLCPCB Part # C2907080
R335, R346: 100k; R_0603_1608Metric; JLCPCB Part # C2907088
U300: CS4270-CZZR; TSSOP-24_4.4x7.8mm_P0.65mm; JLCPCB Part # C1323229
U301, U302, U303: OPA1652-AIDR; SOIC-8; JLCPCB Part # C2928809

Connections:
+3V3: C301.1, C302.1, C303.1, U300.5 (VD), U300.8 (VLC); also elsewhere on the board
+5VA: C304.1, C305.1, C320.1, C326.1, C336.1, U300.19 (VA), U301.8 (V+), U302.8 (V+), U303.8 (V+); also elsewhere on the board
/CODEC/AD0: R314.1, U300.11 (AD0/~CS/I2S/~LJ)
/CODEC/AD1: R315.1, U300.12 (AD1/CDIN/MDIV1)
/CODEC/AD2: R316.1, U300.13 (AD2/MDIV2)
/CODEC/CODEC_MCLK: R308.2, U300.3 (MCLK)
/CODEC/CODEC_NRST_FILT: C311.1, R313.2, U300.14 (~RST)
/CODEC/CODEC_SCLK: R309.2, U300.4 (SCLK)
/CODEC/FILT_PLUS: C314.1, C315.1, U300.18 (FIL+)
/CODEC/IN_BUFF_OUT_A: R328.1, U302.1, U302.2 (-)
/CODEC/IN_BUFF_OUT_B: R339.1, U303.1, U303.2 (-)
/CODEC/IN_BUF_A: C322.2, R327.2, U302.3 (+)
/CODEC/IN_BUF_B: C332.2, R338.2, U303.3 (+)
/CODEC/IN_FILTER_BUF_A: C325.2, R330.2, U302.5 (+)
/CODEC/IN_FILTER_BUF_B: C335.2, R341.2, U303.5 (+)
/CODEC/IN_REFILT_BUF_A: C309.2, R306.2, U301.3 (+)
/CODEC/IN_REFILT_BUF_B: C319.2, R323.2, U301.5 (+)
/CODEC/MUTEA: R311.1, U300.21 (~MUTEA)
/CODEC/MUTEB: R312.1, U300.24 (~MUTEB)
/CODEC/MUTE_FILT: C342.2, R333.1, R344.1, R347.2
/CODEC/MUTE_MOS_GATE_L: C330.1, Q300.1 (G), R333.2, R335.1
/CODEC/MUTE_MOS_GATE_R: C340.1, Q301.1 (G), R344.2, R346.1
/CODEC/OUT_FILTER_BUF_A: C324.1, R331.1, U302.6 (-), U302.7
/CODEC/OUT_FILTER_BUF_B: C334.1, R342.1, U303.6 (-), U303.7
/CODEC/OUT_REFILT_BUF_A: C308.1, R307.1, U301.1, U301.2 (-)
/CODEC/OUT_REFILT_BUF_B: C318.1, R324.1, U301.6 (-), U301.7
/CODEC/VQ: C312.1, C313.1, U300.17 (VQ)
ANALOG_IN_A: C327.1, C328.2, U300.15 (AINA)
ANALOG_IN_B: C337.1, C338.2, U300.16 (AINB)
ANALOG_OUT_A: C306.1, U300.22 (OUTA)
ANALOG_OUT_B: C316.1, U300.23 (OUTB)
CODEC_NRST: C310.1, R313.1; also elsewhere on the board
GND: C301.2, C302.2, C303.2, C304.2, C305.2, C307.1, C309.1, C310.2, C311.2, C312.2, C313.2, C314.2, C315.2, C317.1, C319.1, C320.2, C321.2, C323.1, C325.1, C326.2, C328.1, C330.2, C331.2, C333.1, C335.1, C336.2, C338.1, C340.2, C341.1, C342.1, D300.2, D301.2, D302.2, D303.2, J300.1, J300.3, J300.5, J300.7, Q300.2 (S), Q301.2 (S), R300.2, R310.2, R311.2, R312.2, R314.2, R315.2, R316.2, R317.2, R326.2, R332.1, R335.2, R337.2, R343.1, R346.2, U300.6 (DGND), U300.20 (AGND), U301.4 (V-), U302.4 (V-), U303.4 (V-); also elsewhere on the board
I2C1_SCL: U300.10 (SCL/CCLK/M0); also elsewhere on the board
I2C1_SDA: U300.9 (SDA/CDOUT/M1); also elsewhere on the board
I2S2_CK: R309.1; also elsewhere on the board
I2S2_MCK: R308.1; also elsewhere on the board
I2S2_SD: U300.1 (SDIN); also elsewhere on the board
I2S2_WS: U300.2 (LRCLK); also elsewhere on the board
I2S2_ext_SD: R310.1, U300.7 (SDOUT); also elsewhere on the board
INPUT_L: D302.1, J300.8, R325.1
INPUT_R: D303.1, J300.6, R336.1
MUTE_CTRL: C341.2, R347.1; also elsewhere on the board
MUTE_SHUNT_L: Q300.3 (D), R302.2, R303.2, R304.1
MUTE_SHUNT_R: Q301.3 (D), R319.2, R320.2, R321.1
unnamed: C306.2, R300.1, R301.1
unnamed: C307.2, R304.2, R305.1
unnamed: C308.2, R305.2, R306.1
unnamed: C316.2, R317.1, R318.1
unnamed: C317.2, R321.2, R322.1
unnamed: C318.2, R322.2, R323.1
unnamed: C321.1, C322.1, R325.2, R326.1
unnamed: C323.2, R328.2, R329.1
unnamed: C324.2, R329.2, R330.1
unnamed: C327.2, R331.2, R332.2
unnamed: C331.1, C332.1, R336.2, R337.1
unnamed: C333.2, R339.2, R340.1
unnamed: C334.2, R340.2, R341.1
unnamed: C337.2, R342.2, R343.2
unnamed: R301.2, R302.1
unnamed: R318.2, R319.1
OUTPUT_L: D300.1, J300.4, R307.2
OUTPUT_R: D301.1, J300.2, R324.2
VCOM: R303.1, R320.1, R327.1, R338.1; also elsewhere on the board

Notes on the sheet:
IN_RF_A
Analog Front-End (Left and Right channels)
Mute Circuit
Rin = 1.1M
IO Header
Use C0G/NP0 capacitors
RF filter: fc=1.1MHz
IN_RF_B
CODEC
Analog Rear-End (Left and Right channels)
SDOUT=0 -> Slave mode

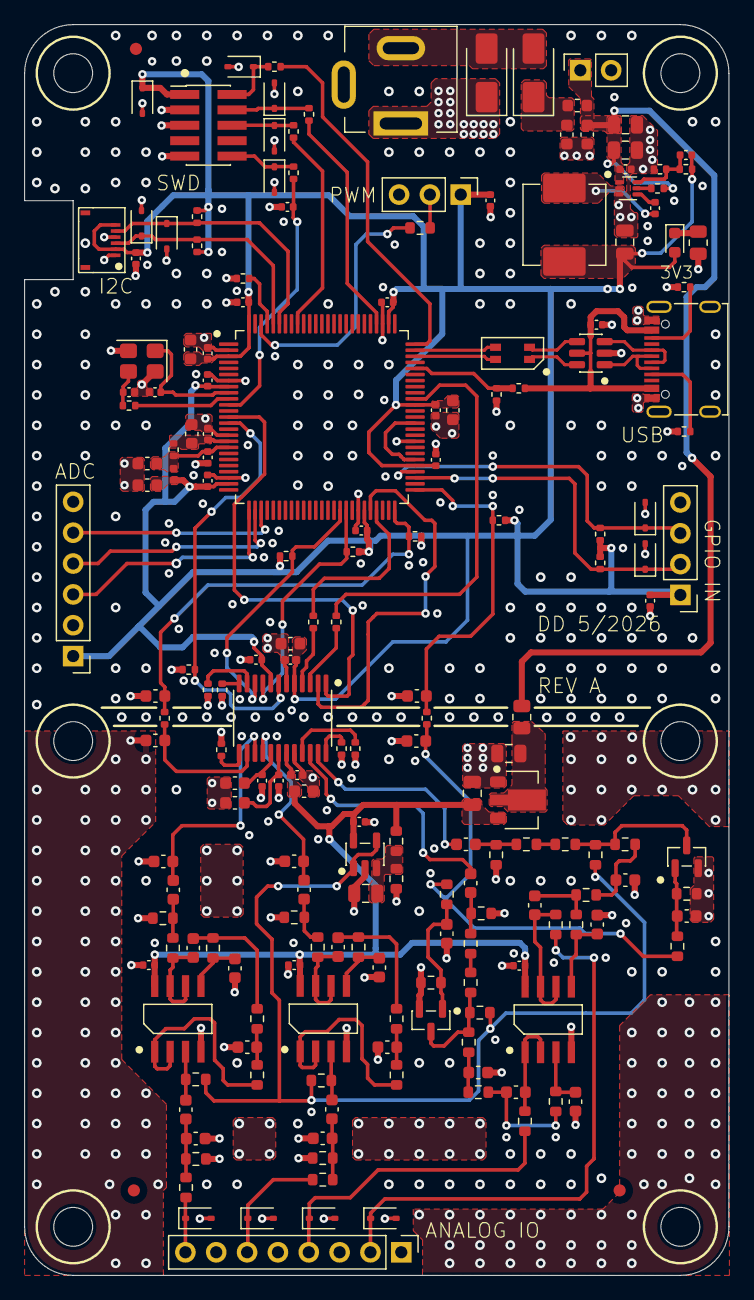
[picture p9: board DeniSP.kicad_pcb from above]

Board: 4 copper layers, 58.0 x 103.0 mm, 194 parts (0 on the bottom side), 108 nets.
