ddenchevDev/Electronics-Projects-Public/(commit log)

2026-09-20 DeniSP - Initial Commit
    [Analog_connectors.kicad_sch, DeniSP-placement.csv, DeniSP.csv, DeniSP.kicad_pcb, DeniSP.kicad_sch, DeniSP_bom.csv, codec.kicad_sch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]
2026-09-22 Uploading schematic in pdf
